kasirnotaku/SOlder_T12/Skematich/Schematic_Arduino Soldering Station.png

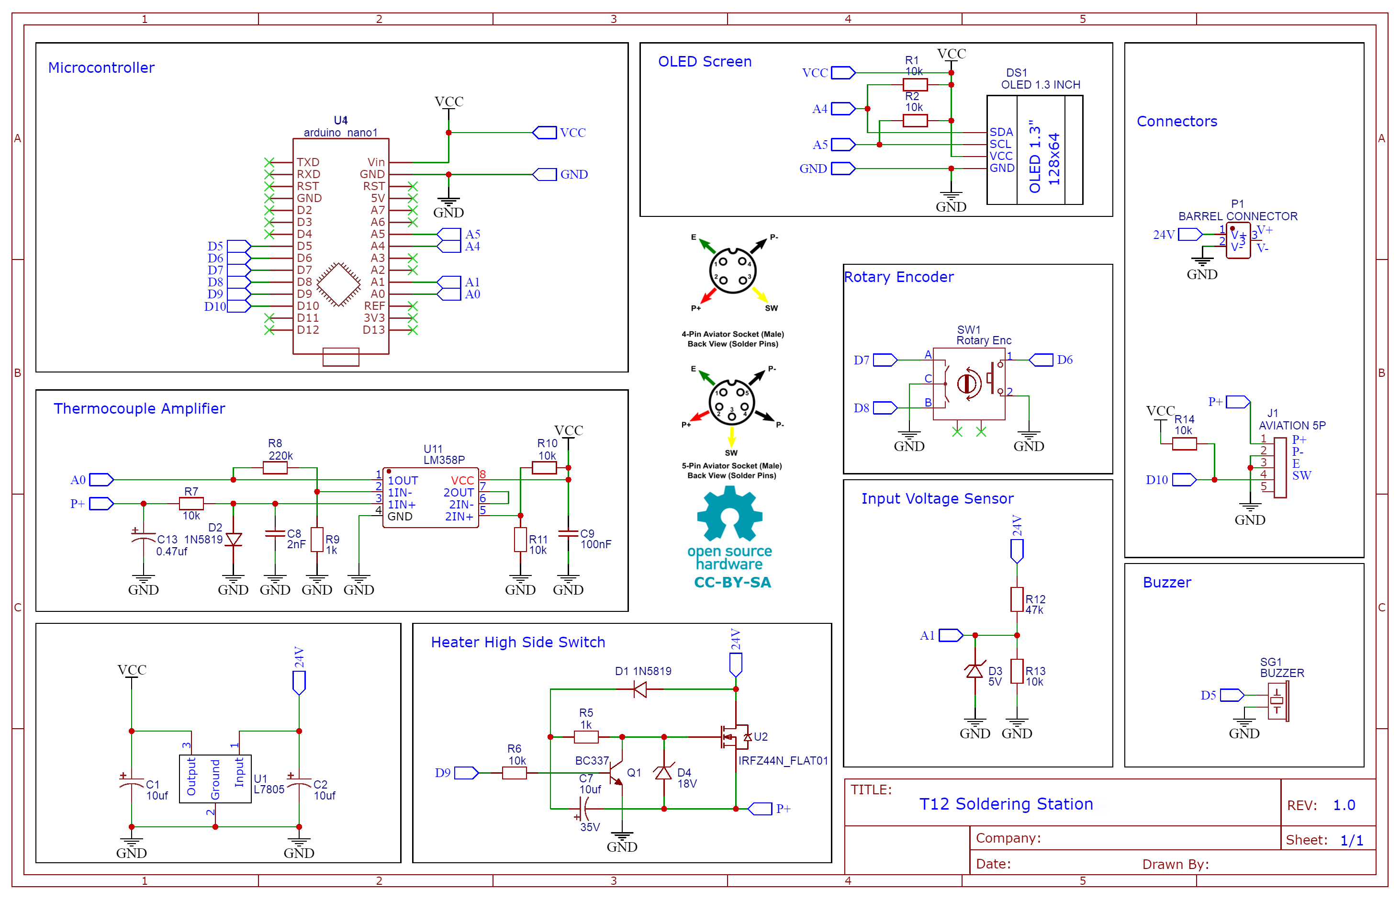
Skematich/Schematic_Arduino Soldering Station.png
